psas/psas-kicad/psas-3dmodels/U-PUI-SMT-0440-S-R.stp

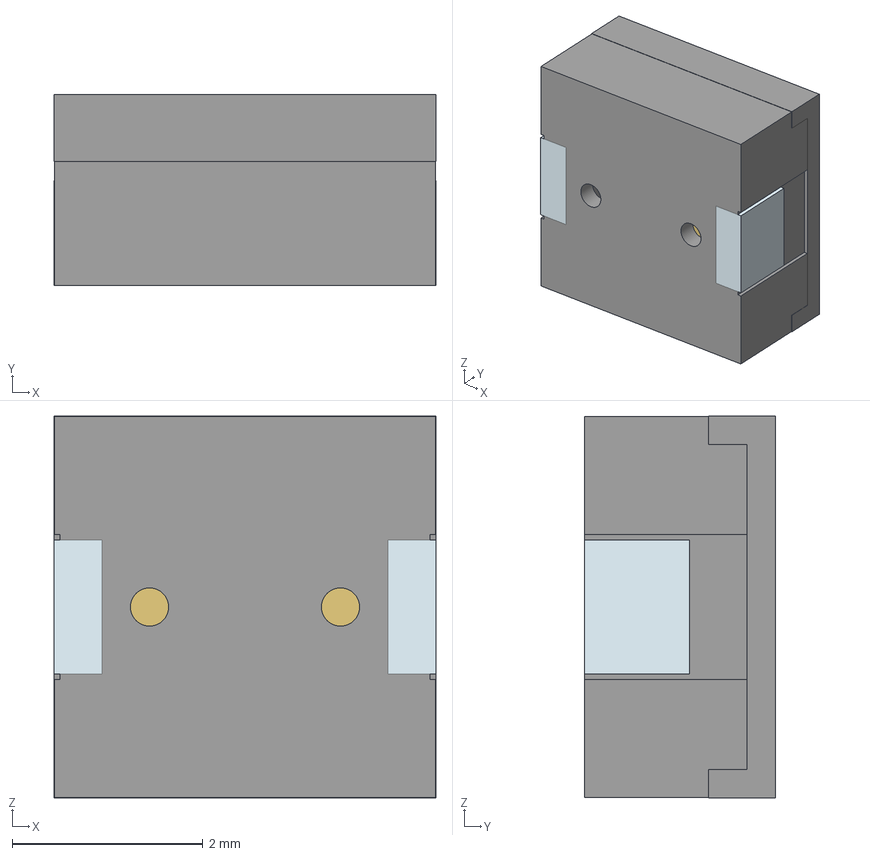
[picture p1: CAD file, 2023-01-22]
psas-3dmodels/U-PUI-SMT-0440-S-R.stp
4.00 x 2.00 x 4.00 mm
