psas/psas-kicad/psas-3dmodels/J-TE-2-1734592-0-c-3d.stp

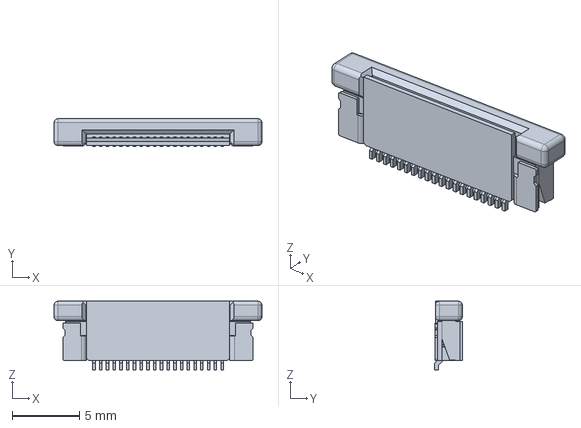
[picture p2: CAD file, 2022-11-02]
psas-3dmodels/J-TE-2-1734592-0-c-3d.stp
15.4 x 2.05 x 5.11 mm
