psas/psas-kicad/psas-3dmodels/mill-max-1578-3-00-15-00-00-03-0.step

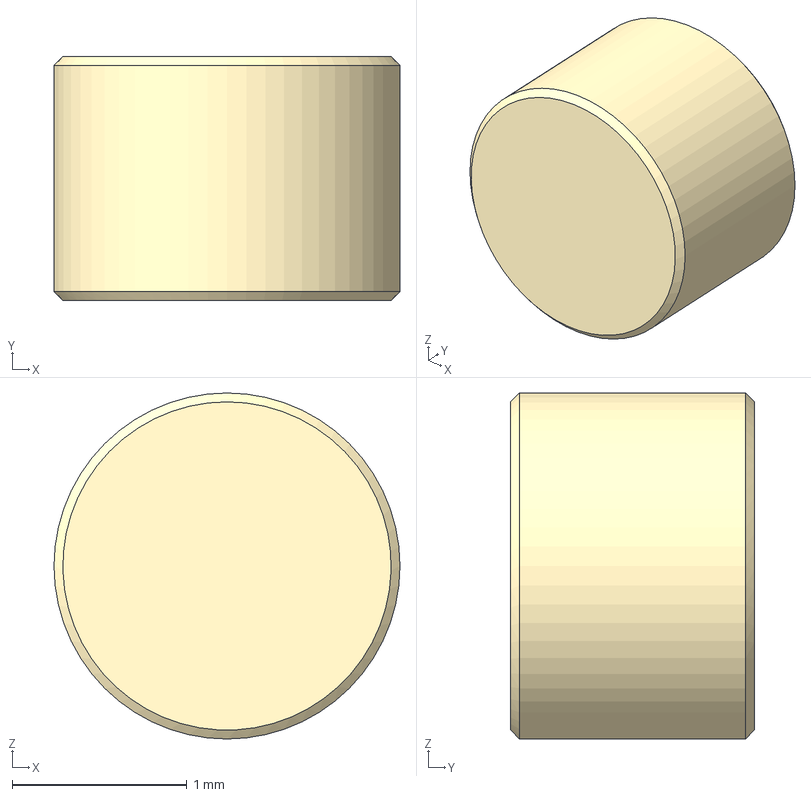
[picture p3: CAD file, 2022-09-22]
psas-3dmodels/mill-max-1578-3-00-15-00-00-03-0.step
1.98 x 1.40 x 1.98 mm
