psas/psas-kicad/psas-3dmodels/U-TI-022232031.stp

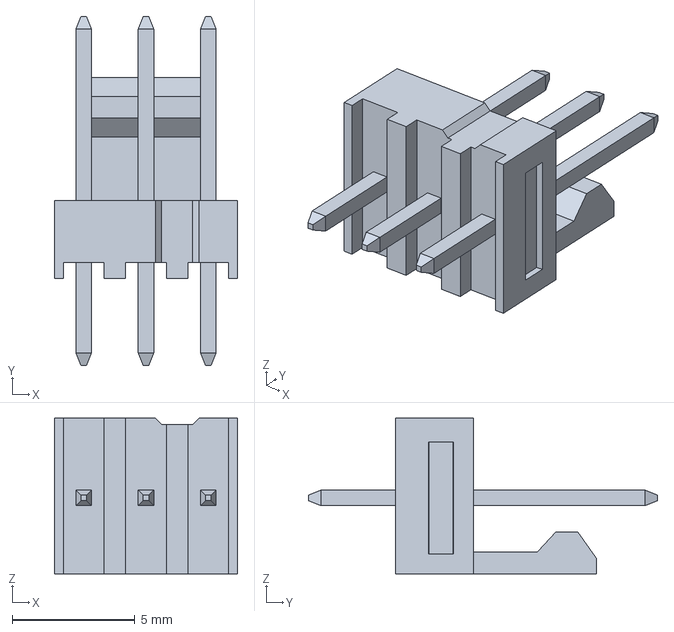
[picture p4: CAD file, 2022-09-22]
psas-3dmodels/U-TI-022232031.stp
7.47 x 14.2 x 6.35 mm
