psas/psas-kicad/psas-3dmodels/mill-max-0921-5-15-20-77-14-11-0 .step

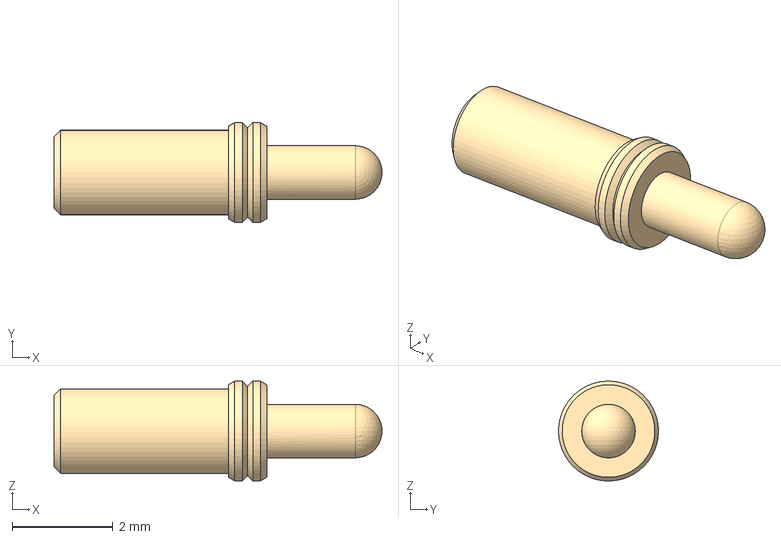
[picture p5: CAD file, 2022-09-22]
psas-3dmodels/mill-max-0921-5-15-20-77-14-11-0 .step
6.50 x 1.98 x 1.98 mm
