psas/psas-kicad/Reference catalog/Charger example/Battery charger from ERS/Battery charger from ERS.kicad_sch

## KiCad design Reference catalog/Charger example/Battery charger from ERS/Battery charger from ERS.kicad_sch (2025-09-12)

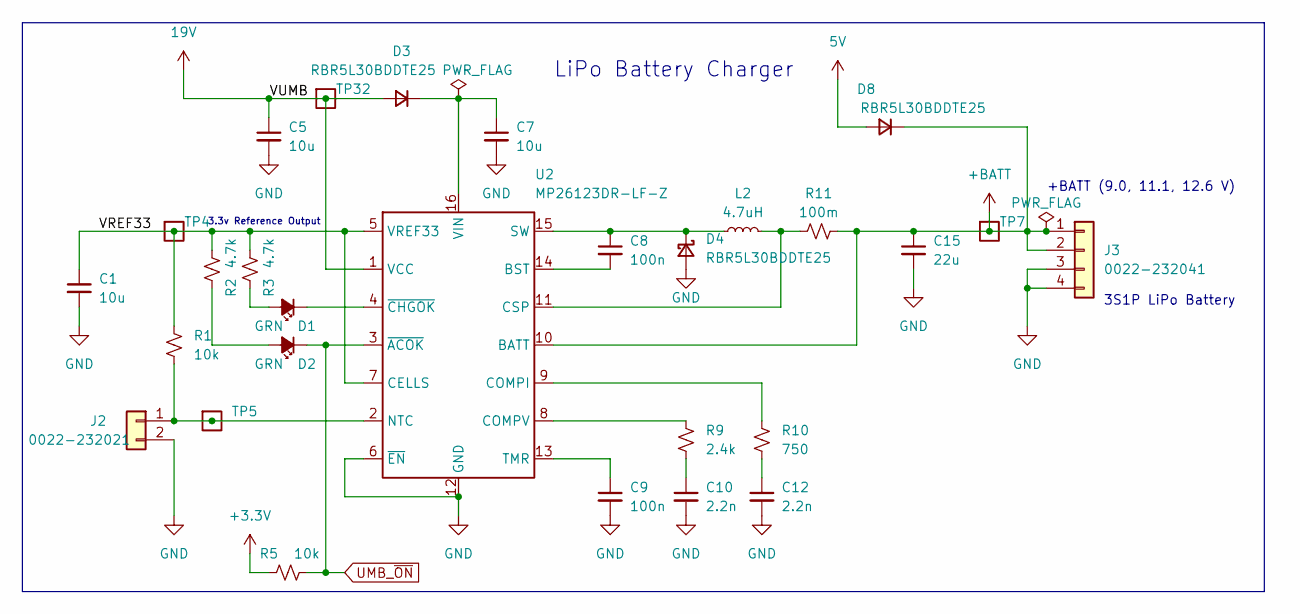
[picture p6: schematic Battery charger from ERS.kicad_sch]

Parts:
C1, C5, C7: 10u; C_0805_2012Metric; MPN GRM21BR61H106KE43L
C8, C9: 100n; C_0603_1608Metric; MPN CL10B104KB8WPNC
C10, C12: 2.2n; C_0603_1608Metric; MPN CL10B222KB8WPNC
C15: 22u; C_0805_2012Metric; MPN GRT21BR61E226ME13L
D1, D2: GRN; LED_0603_1608Metric; MPN 150060GS75000
D3, D4, D8: RBR5L30BDDTE25; D_SMA; MPN RBR5L30BDDTE25
J2: 0022-232021; Molex_KK-254_AE-6410-02A_1x02_P2.54mm_Vertical; MPN 22232021
J3: 0022-232041; Molex_KK-254_AE-6410-04A_1x04_P2.54mm_Vertical; MPN 22232041
L2: 4.7uH; L_Vishay_IHLP-2020; MPN IHLP2020BZER4R7M11
R1, R5: 10k; R_0603_1608Metric; MPN RC0603FR-0710KL
R2, R3: 4.7k; R_0603_1608Metric; MPN RC0603FR-074K7L
R9: 2.4k; R_0603_1608Metric; MPN RC0603FR-072K4L
R10: 750; R_0603_1608Metric; MPN RC0603FR-07750RL
R11: 100m; R_1206_3216Metric; MPN CSR1206FTR100
TP4, TP5, TP7, TP32: Test-Point; TP-through-hole-1X01
U2: MP26123DR-LF-Z; QFN-16-1EP_4x4mm_P0.65mm_EP2.5x2.5mm; MPN MP26123DR-LF-Z

Connections:
5V: D8.2 (A)
19V: C5.1, D3.2 (A), TP32.1, U2.1 (VCC)
+3.3V: R5.1
+BATT: C15.1, D8.1 (K), J3.1, J3.2, R11.2, TP7.1, U2.10 (BATT)
GND: C1.2, C5.2, C7.2, C9.2, C10.2, C12.2, C15.2, D4.2 (A), J2.2, J3.3, J3.4, U2.6 (~EN), U2.12 (GND), U2.17 (GND)
unnamed: C7.1, D3.1 (K), U2.16 (VIN)
unnamed: C8.1, D4.1 (K), L2.1, U2.15 (SW)
unnamed: C8.2, U2.14 (BST)
unnamed: C9.1, U2.13 (TMR)
unnamed: C10.1, R9.2
unnamed: C12.1, R10.2
unnamed: D1.1 (K), U2.4 (~CHGOK)
unnamed: D1.2 (A), R3.2
unnamed: D2.2 (A), R2.2
unnamed: J2.1, R1.2, TP5.1, U2.2 (NTC)
unnamed: L2.2, R11.1, U2.11 (CSP)
unnamed: R9.1, U2.8 (COMPV)
unnamed: R10.1, U2.9 (COMPI)
UMB_~ON: D2.1 (K), R5.2, U2.3 (~ACOK)
VREF33: C1.1, R1.1, R2.1, R3.1, TP4.1, U2.5 (VREF33), U2.7 (CELLS)

Notes on the sheet:
3S1P LiPo Battery
3.3v Reference Output
+BATT (9.0, 11.1, 12.6 V)
LiPo Battery Charger
