psas/psas-kicad/(commit log)

2022-09-22 Added some libraries for ERS stuff
    [U-TI-022232031.stp, mill-max-0921-5-15-20-77-14-11-0 .step, mill-max-1578-3-00-15-00-00-03-0.step]
2022-11-02 Added recovery board libraries
    [J-TE-2-1734592-0-c-3d.stp]
2023-01-22 ERS board 3D model
    [U-PUI-SMT-0440-S-R.stp]
2023-01-22 ERS board libraries
2025-08-27 Fixes to BD motor driver
2025-09-12 Started a new folder for the reference catalog project
    [Battery charger from ERS.kicad_pcb, Battery charger from ERS.kicad_sch]
